calstar/le2-avionics/README.md

# LE2 Avionics 

Hardware for LE2 data acquisition (DAQ) board. 

### [Ground DAQ Spec](https://docs.google.com/document/d/13VDrlMz54n0tT20tYANPPuO85ihRtZlENfx5LBO277A/edit#)  

### [BOM](https://docs.google.com/spreadsheets/d/11PVgNdWwZuFMgkslr21FnstDzzs_OCHczlblnQA5oqc/edit#gid=0)
