calstar/le2-avionics/3d_print_project/le3_periphrialSLDPRT.SLDPRT

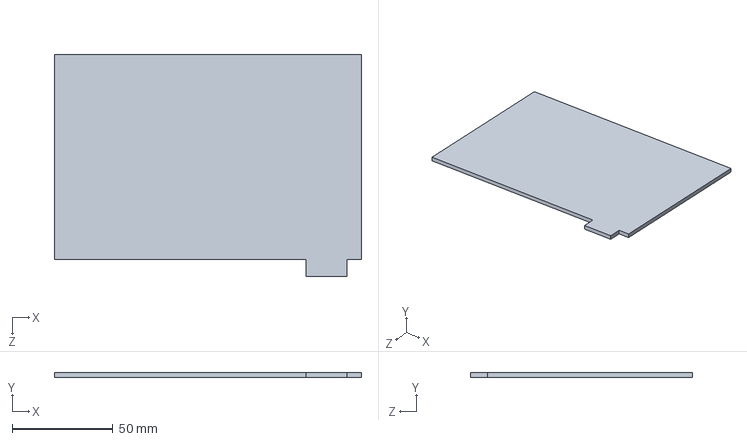
[picture p1: CAD file, 2022-11-15]
3d_print_project/le3_periphrialSLDPRT.SLDPRT
152.4 x 2.54 x 110.0 mm
