calstar/le2-avionics/3d_print_project/le3_core.SLDPRT

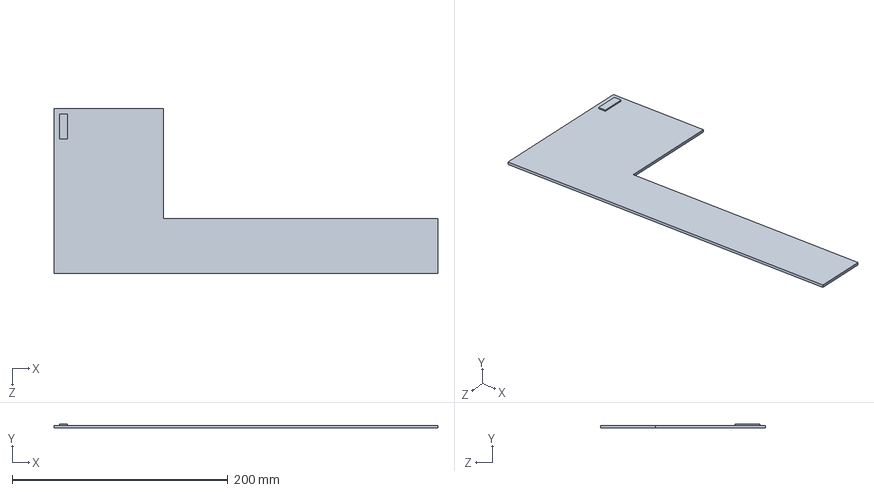
[picture p2: CAD file, 2022-11-15]
3d_print_project/le3_core.SLDPRT
355.6 x 3.81 x 152.4 mm
