calstar/le2-avionics/3d_print_project/final_part.SLDPRT

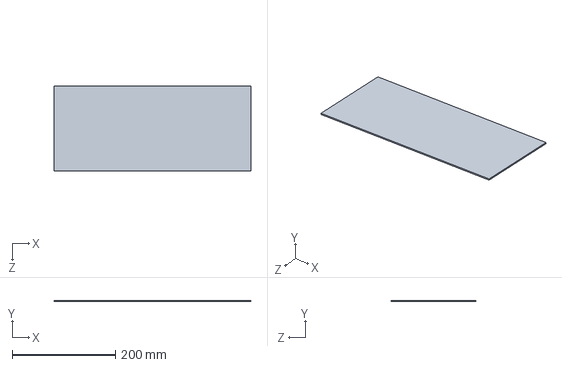
[picture p3: CAD file, 2022-11-15]
3d_print_project/final_part.SLDPRT
381.0 x 2.54 x 165.1 mm
