calstar/le2-avionics/(list of files, cad)

Other CAD files:
3d_print_project/core_board.SLDPRT
