calstar/le2-avionics/core_board/buck_converter.kicad_sch

## KiCad design core_board/buck_converter.kicad_sch (2022-10-28)

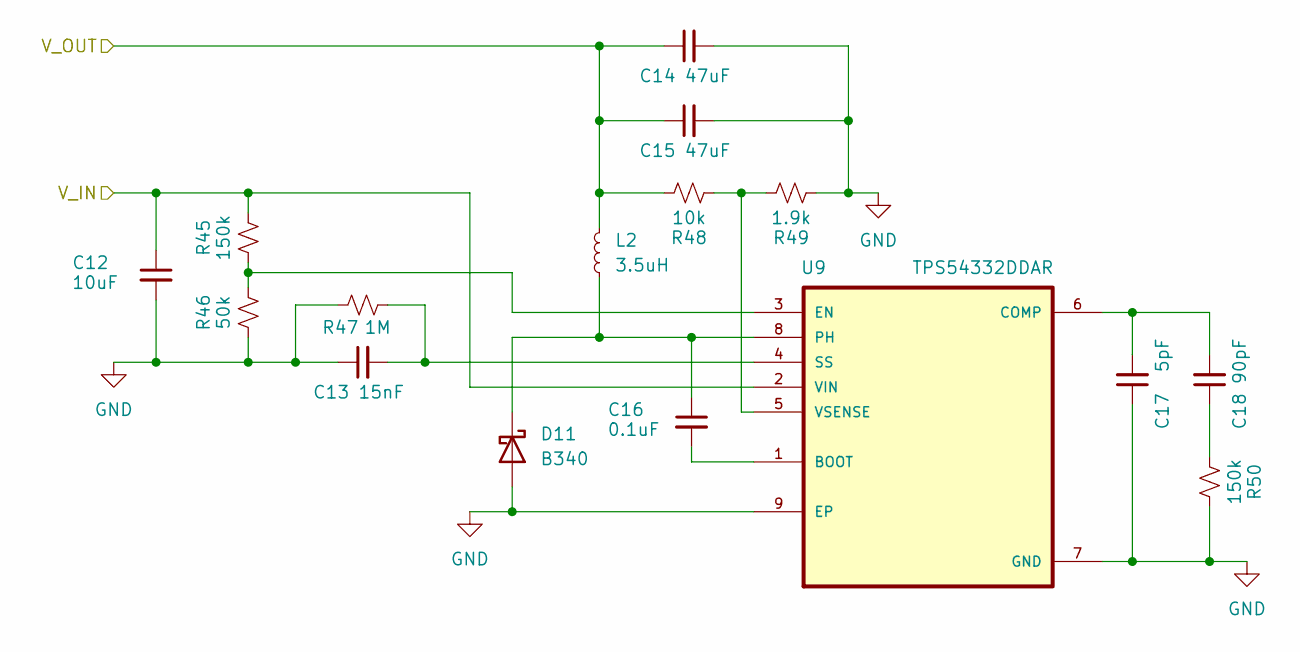
[picture p4: schematic buck_converter.kicad_sch]

Parts:
C12: 10uF; C_0603_1608Metric
C13: 15nF; C_0603_1608Metric
C14, C15: 47uF; C_1206_3216Metric
C16: 0.1uF; C_0603_1608Metric
C17: 5pF; C_0603_1608Metric
C18: 90pF; C_0603_1608Metric
D11: B340; D_SMA
L2: 3.5uH; L_Bourns_SRP5030T
R45, R50: 150k; R_0603_1608Metric
R46: 50k; R_0603_1608Metric
R47: 1M; R_0603_1608Metric
R48: 10k; R_0603_1608Metric
R49: 1.9k; R_0603_1608Metric
U9: TPS54332DDAR; VREG_LM5017MR_NOPB

Connections:
GND: C12.2, C13.1, C14.2, C15.2, C17.1, D11.2 (A), R46.1, R47.1, R49.1, R50.2, U9.7 (GND), U9.9 (EP)
unnamed: C13.2, R47.2, U9.4 (SS)
unnamed: C16.1, D11.1 (K), L2.1, U9.8 (PH)
unnamed: C16.2, U9.1 (BOOT)
unnamed: C17.2, C18.2, U9.6 (COMP)
unnamed: C18.1, R50.1
unnamed: R45.1, R46.2, U9.3 (EN)
unnamed: R48.1, R49.2, U9.5 (VSENSE)
V_IN: C12.1, R45.2, U9.2 (VIN)
V_OUT: C14.1, C15.1, L2.2, R48.2
