calstar/le2-avionics/core_board/core_board.kicad_sch

## KiCad design core_board/core_board.kicad_sch (2022-10-28)

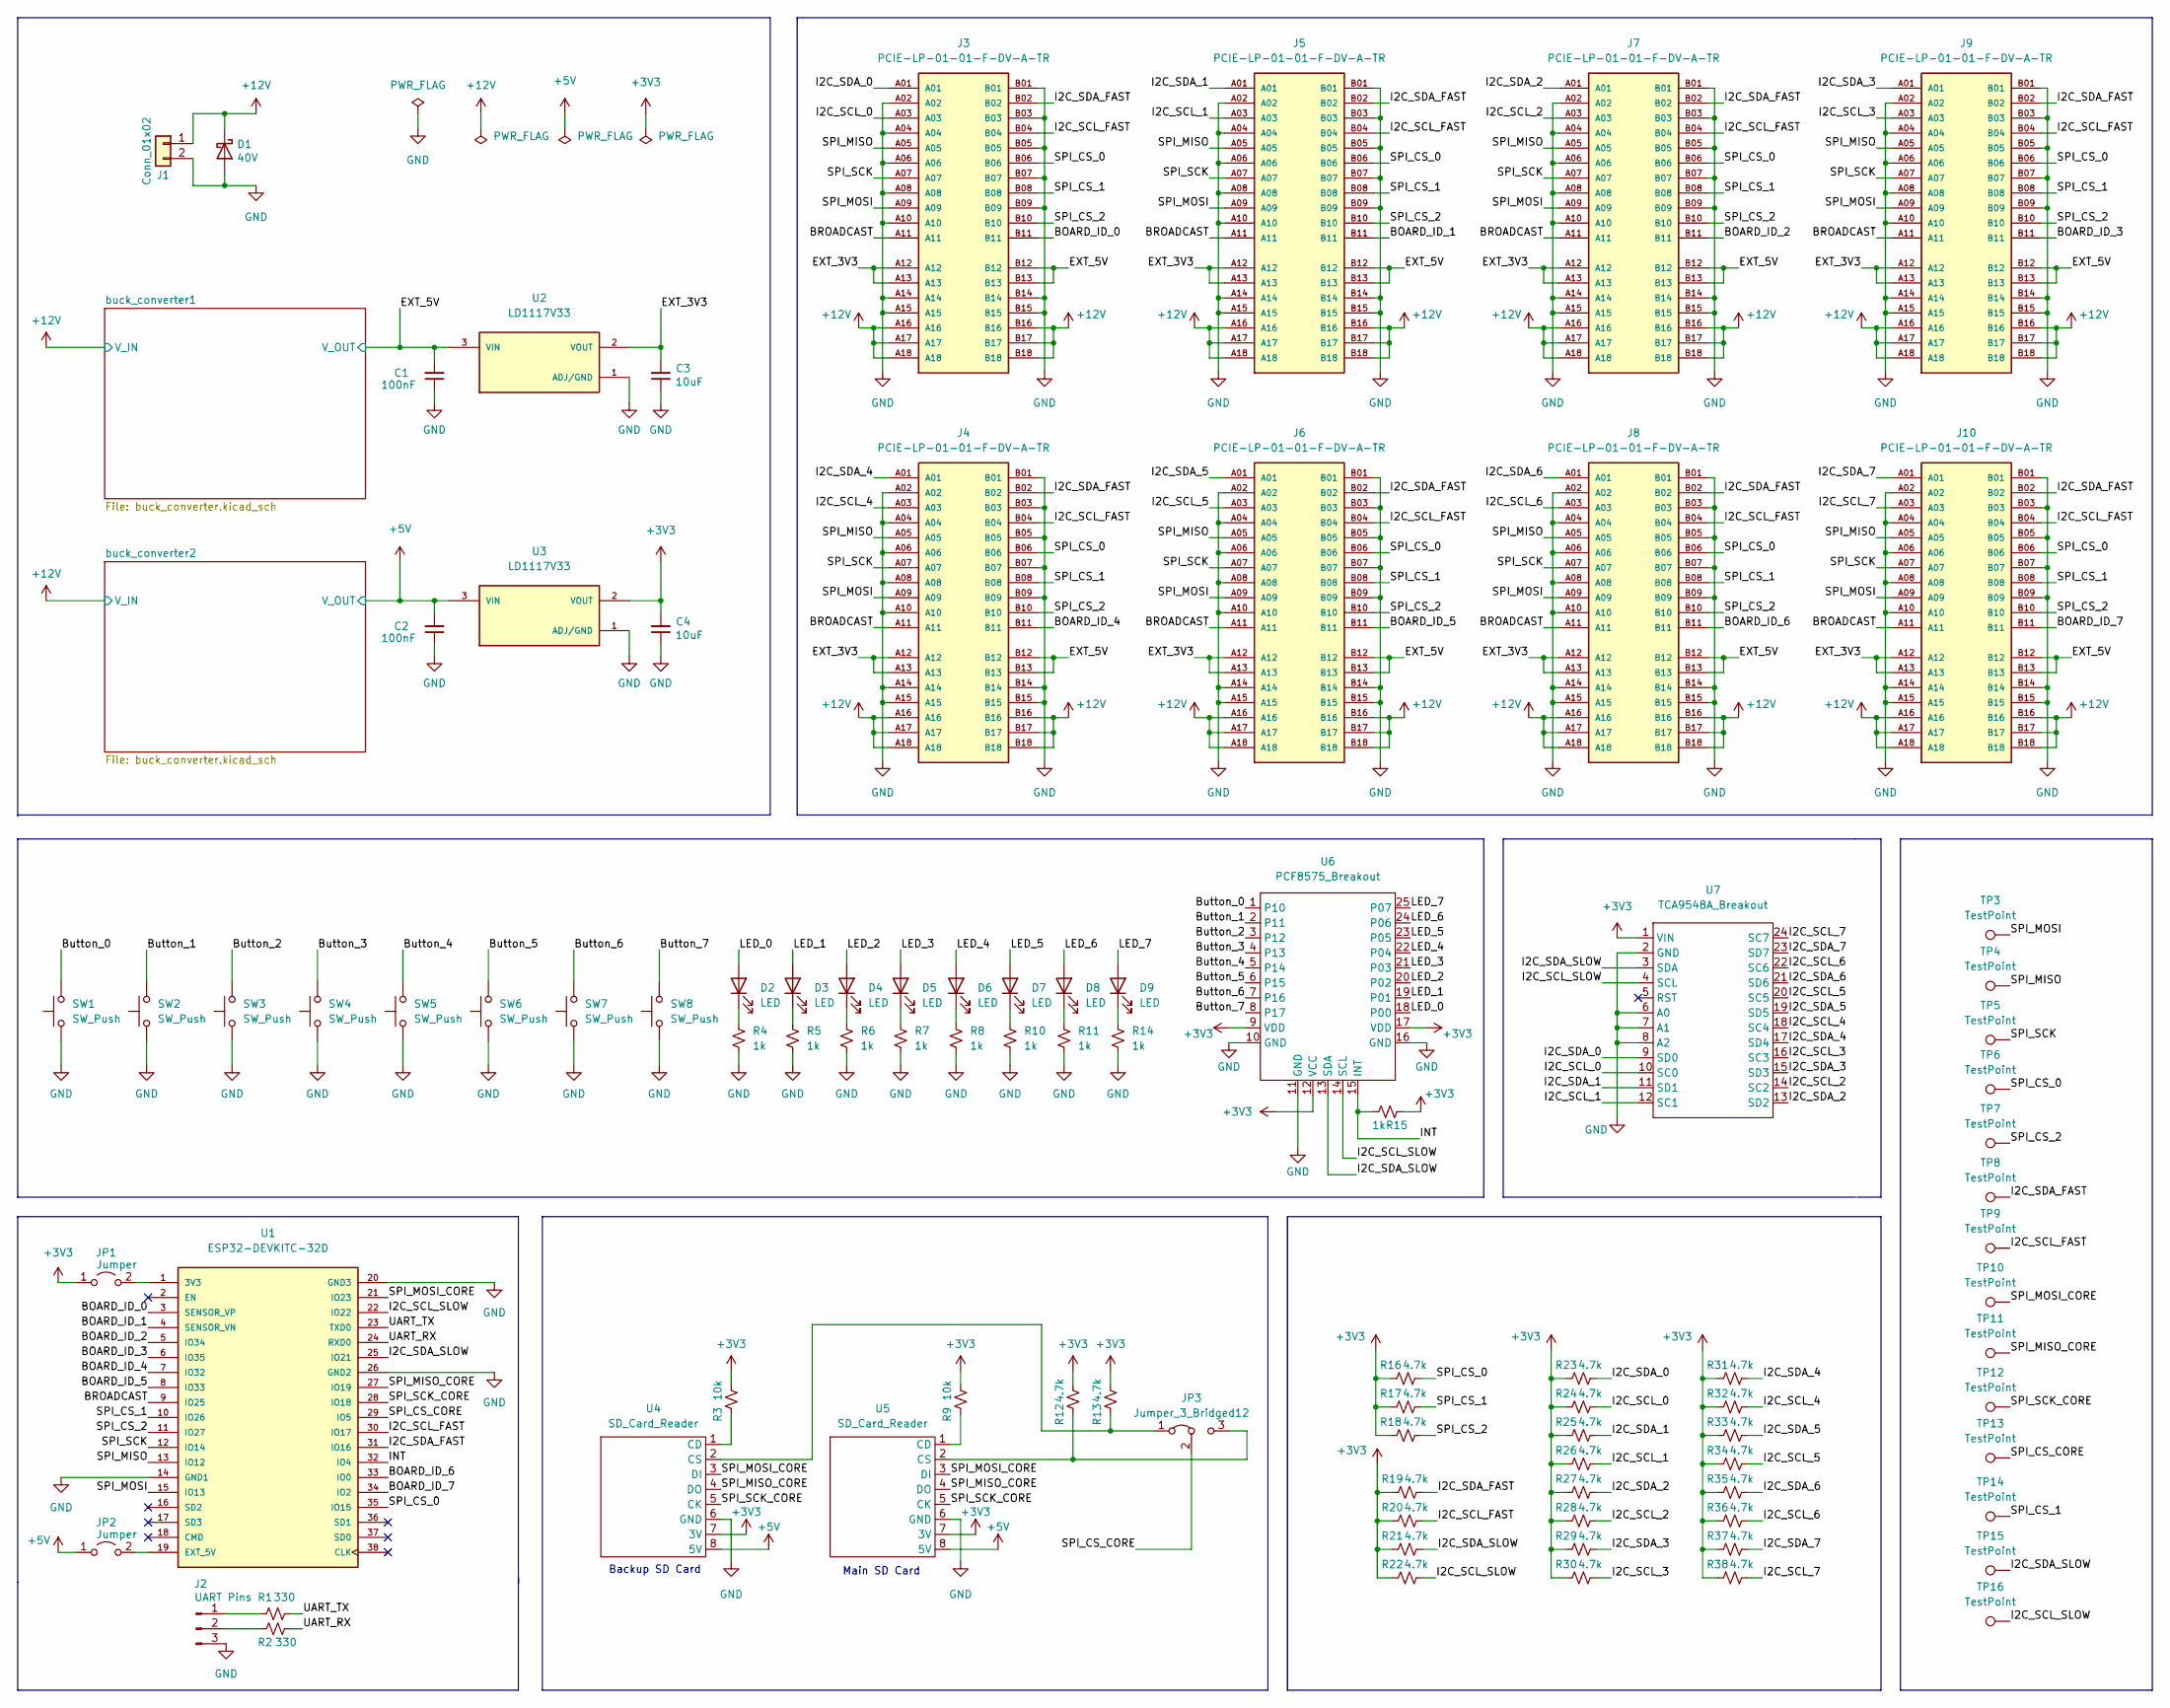
[picture p5: schematic core_board.kicad_sch]

Parts:
C1, C2: 100nF; C_0603_1608Metric
C3, C4: 10uF; C_0603_1608Metric
D1: 40V; D_0603_1608Metric; DIGIKEY 478-7798-1-ND
D2, D3, D4, D5, D6, D7, D8, D9: LED; LED_0603_1608Metric
J1: Conn_01x02; DEANS
J2: UART Pins; PinHeader_1x03_P2.54mm_Vertical
J3, J4, J5, J6, J7, J8, J9, J10: PCIE-LP-01-01-F-DV-A-TR; SAMTEC_PCIE-LP-01-01-F-DV-A-TR; PARTREV B
JP1, JP2: Jumper; PinHeader_1x02_P2.54mm_Vertical
JP3: Jumper_3_Bridged12; PinHeader_1x03_P2.54mm_Vertical
R1, R2: 330; R_0603_1608Metric
R3, R9: 10k; R_0603_1608Metric
R4, R5, R6, R7, R8, R10, R11, R14, R15: 1k; R_0603_1608Metric
R12, R13, R16, R17, R18, R19, R20, R21, R22, R23, R24, R25, R26, R27, R28, R29, R30, R31, R32, R33, R34, R35, R36, R37, R38: 4.7k; R_0603_1608Metric
SW1, SW2, SW3, SW4, SW5, SW6, SW7, SW8: SW_Push; SW_SPST_PTS810
TP3, TP4, TP5, TP6, TP7, TP8, TP9, TP10, TP11, TP12, TP13, TP14, TP15, TP16: TestPoint; TestPoint_Plated_Hole_D2.0mm
U1: ESP32-DEVKITC-32D; MODULE_ESP32-DEVKITC-32D; PARTREV 4
U2, U3: LD1117V33; TO255P1020X450X1968-3; PARTREV 37
U4, U5: SD_Card_Reader; SD_Card_Breakout
U6: PCF8575_Breakout
U7: TCA9548A_Breakout

Connections:
+3V3: C4.2, JP1.1 (A), R3.2, R9.2, R12.2, R13.2, R15.1, R16.1, R17.1, R18.1, R19.1, R20.1, R21.1, R22.1, R23.1, R24.1, R25.1, R26.1, R27.1, R28.1, R29.1, R30.1, R31.1, R32.1, R33.1, R34.1, R35.1, R36.1, R37.1, R38.1, U3.2 (VOUT), U4.7 (3V), U5.7 (3V), U6.9 (VDD), U6.12 (VCC), U6.17 (VDD), U7.1 (VIN)
+5V: C2.2, JP2.1 (A), U3.3 (VIN), U4.8 (5V), U5.8 (5V)
+12V: D1.1 (K), J1.1, J3.A16, J3.A17, J3.A18, J3.B16, J3.B17, J3.B18, J4.A16, J4.A17, J4.A18, J4.B16, J4.B17, J4.B18, J5.A16, J5.A17, J5.A18, J5.B16, J5.B17, J5.B18, J6.A16, J6.A17, J6.A18, J6.B16, J6.B17, J6.B18, J7.A16, J7.A17, J7.A18, J7.B16, J7.B17, J7.B18, J8.A16, J8.A17, J8.A18, J8.B16, J8.B17, J8.B18, J9.A16, J9.A17, J9.A18, J9.B16, J9.B17, J9.B18, J10.A16, J10.A17, J10.A18, J10.B16, J10.B17, J10.B18
BOARD_ID_0: J3.B11, U1.3 (SENSOR_VP)
BOARD_ID_1: J5.B11, U1.4 (SENSOR_VN)
BOARD_ID_2: J7.B11, U1.5 (IO34)
BOARD_ID_3: J9.B11, U1.6 (IO35)
BOARD_ID_4: J4.B11, U1.7 (IO32)
BOARD_ID_5: J6.B11, U1.8 (IO33)
BOARD_ID_6: J8.B11, U1.33 (IO0)
BOARD_ID_7: J10.B11, U1.34 (IO2)
BROADCAST: J3.A11, J4.A11, J5.A11, J6.A11, J7.A11, J8.A11, J9.A11, J10.A11, U1.9 (IO25)
Button_0: SW1.2, U6.1 (P10)
Button_1: SW2.2, U6.2 (P11)
Button_2: SW3.2, U6.3 (P12)
Button_3: SW4.2, U6.4 (P13)
Button_4: SW5.2, U6.5 (P14)
Button_5: SW6.2, U6.6 (P15)
Button_6: SW7.2, U6.7 (P16)
Button_7: SW8.2, U6.8 (P17)
EXT_3V3: C3.2, J3.A12, J3.A13, J4.A12, J4.A13, J5.A12, J5.A13, J6.A12, J6.A13, J7.A12, J7.A13, J8.A12, J8.A13, J9.A12, J9.A13, J10.A12, J10.A13, U2.2 (VOUT)
EXT_5V: C1.2, J3.B12, J3.B13, J4.B12, J4.B13, J5.B12, J5.B13, J6.B12, J6.B13, J7.B12, J7.B13, J8.B12, J8.B13, J9.B12, J9.B13, J10.B12, J10.B13, U2.3 (VIN)
GND: C1.1, C2.1, C3.1, C4.1, D1.2 (A), J1.2, J2.3, J3.A02, J3.A04, J3.A06, J3.A08, J3.A10, J3.A14, J3.A15, J3.B01, J3.B03, J3.B05, J3.B07, J3.B09, J3.B14, J3.B15, J4.A02, J4.A04, J4.A06, J4.A08, J4.A10, J4.A14, J4.A15, J4.B01, J4.B03, J4.B05, J4.B07, J4.B09, J4.B14, J4.B15, J5.A02, J5.A04, J5.A06, J5.A08, J5.A10, J5.A14, J5.A15, J5.B01, J5.B03, J5.B05, J5.B07, J5.B09, J5.B14, J5.B15, J6.A02, J6.A04, J6.A06, J6.A08, J6.A10, J6.A14, J6.A15, J6.B01, J6.B03, J6.B05, J6.B07, J6.B09, J6.B14, J6.B15, J7.A02, J7.A04, J7.A06, J7.A08, J7.A10, J7.A14, J7.A15, J7.B01, J7.B03, J7.B05, J7.B07, J7.B09, J7.B14, J7.B15, J8.A02, J8.A04, J8.A06, J8.A08, J8.A10, J8.A14, J8.A15, J8.B01, J8.B03, J8.B05, J8.B07, J8.B09, J8.B14, J8.B15, J9.A02, J9.A04, J9.A06, J9.A08, J9.A10, J9.A14, J9.A15, J9.B01, J9.B03, J9.B05, J9.B07, J9.B09, J9.B14, J9.B15, J10.A02, J10.A04, J10.A06, J10.A08, J10.A10, J10.A14, J10.A15, J10.B01, J10.B03, J10.B05, J10.B07, J10.B09, J10.B14, J10.B15, R4.2, R5.2, R6.2, R7.2, R8.2, R10.2, R11.2, R14.2, SW1.1, SW2.1, SW3.1, SW4.1, SW5.1, SW6.1, SW7.1, SW8.1, U1.14 (GND1), U1.20 (GND3), U1.26 (GND2), U2.1 (ADJ/GND), U3.1 (ADJ/GND), U4.6 (GND), U5.6 (GND), U6.10 (GND), U6.11 (GND), U6.16 (GND), U7.2 (GND), U7.6 (A0), U7.7 (A1), U7.8 (A2)
I2C_SCL_0: J3.A03, R24.2, U7.10 (SC0)
I2C_SCL_1: J5.A03, R26.2, U7.12 (SC1)
I2C_SCL_2: J7.A03, R28.2, U7.14 (SC2)
I2C_SCL_3: J9.A03, R30.2, U7.16 (SC3)
I2C_SCL_4: J4.A03, R32.2, U7.18 (SC4)
I2C_SCL_5: J6.A03, R34.2, U7.20 (SC5)
I2C_SCL_6: J8.A03, R36.2, U7.22 (SC6)
I2C_SCL_7: J10.A03, R38.2, U7.24 (SC7)
I2C_SCL_FAST: J3.B04, J4.B04, J5.B04, J6.B04, J7.B04, J8.B04, J9.B04, J10.B04, R20.2, TP9.1, U1.30 (IO17)
I2C_SCL_SLOW: R22.2, TP16.1, U1.22 (IO22), U6.14 (SCL), U7.4 (SCL)
I2C_SDA_0: J3.A01, R23.2, U7.9 (SD0)
I2C_SDA_1: J5.A01, R25.2, U7.11 (SD1)
I2C_SDA_2: J7.A01, R27.2, U7.13 (SD2)
I2C_SDA_3: J9.A01, R29.2, U7.15 (SD3)
I2C_SDA_4: J4.A01, R31.2, U7.17 (SD4)
I2C_SDA_5: J6.A01, R33.2, U7.19 (SD5)
I2C_SDA_6: J8.A01, R35.2, U7.21 (SD6)
I2C_SDA_7: J10.A01, R37.2, U7.23 (SD7)
I2C_SDA_FAST: J3.B02, J4.B02, J5.B02, J6.B02, J7.B02, J8.B02, J9.B02, J10.B02, R19.2, TP8.1, U1.31 (IO16)
I2C_SDA_SLOW: R21.2, TP15.1, U1.25 (IO21), U6.13 (SDA), U7.3 (SDA)
INT: R15.2, U1.32 (IO4), U6.15 (INT)
LED_0: D2.2 (A), U6.18 (P00)
LED_1: D3.2 (A), U6.19 (P01)
LED_2: D4.2 (A), U6.20 (P02)
LED_3: D5.2 (A), U6.21 (P03)
LED_4: D6.2 (A), U6.22 (P04)
LED_5: D7.2 (A), U6.23 (P05)
LED_6: D8.2 (A), U6.24 (P06)
LED_7: D9.2 (A), U6.25 (P07)
unnamed: D2.1 (K), R4.1
unnamed: D3.1 (K), R5.1
unnamed: D4.1 (K), R6.1
unnamed: D5.1 (K), R7.1
unnamed: D6.1 (K), R8.1
unnamed: D7.1 (K), R10.1
unnamed: D8.1 (K), R11.1
unnamed: D9.1 (K), R14.1
unnamed: J2.1, R1.1
unnamed: J2.2, R2.1
unnamed: JP1.2 (B), U1.1 (3V3)
unnamed: JP2.2 (B), U1.19 (EXT_5V)
unnamed: JP3.1 (A), R13.1, U4.2 (CS)
unnamed: JP3.3 (B), R12.1, U5.2 (CS)
unnamed: R3.1, U4.1 (CD)
unnamed: R9.1, U5.1 (CD)
SPI_CS_0: J3.B06, J4.B06, J5.B06, J6.B06, J7.B06, J8.B06, J9.B06, J10.B06, R16.2, TP6.1, U1.35 (IO15)
SPI_CS_1: J3.B08, J4.B08, J5.B08, J6.B08, J7.B08, J8.B08, J9.B08, J10.B08, R17.2, TP14.1, U1.10 (IO26)
SPI_CS_2: J3.B10, J4.B10, J5.B10, J6.B10, J7.B10, J8.B10, J9.B10, J10.B10, R18.2, TP7.1, U1.11 (IO27)
SPI_CS_CORE: JP3.2 (C), TP13.1, U1.29 (IO5)
SPI_MISO: J3.A05, J4.A05, J5.A05, J6.A05, J7.A05, J8.A05, J9.A05, J10.A05, TP4.1, U1.13 (IO12)
SPI_MISO_CORE: TP11.1, U1.27 (IO19), U4.4 (DO), U5.4 (DO)
SPI_MOSI: J3.A09, J4.A09, J5.A09, J6.A09, J7.A09, J8.A09, J9.A09, J10.A09, TP3.1, U1.15 (IO13)
SPI_MOSI_CORE: TP10.1, U1.21 (IO23), U4.3 (DI), U5.3 (DI)
SPI_SCK: J3.A07, J4.A07, J5.A07, J6.A07, J7.A07, J8.A07, J9.A07, J10.A07, TP5.1, U1.12 (IO14)
SPI_SCK_CORE: TP12.1, U1.28 (IO18), U4.5 (CK), U5.5 (CK)
UART_RX: R2.2, U1.24 (RXD0)
UART_TX: R1.2, U1.23 (TXD0)

Notes on the sheet:
Main SD Card
Backup SD Card
