calstar/le2-avionics/(commit log)

2022-09-13 igniter schematic work in progress
    [igniter_board.kicad_pcb, igniter_board.kicad_sch]
2022-09-18 Started on Core Board schematic
    [core_board.kicad_pcb, core_board.kicad_sch]
2022-09-23 small updates
    [core_board.kicad_sch]
2022-09-26 finished schematic
    [core_board.kicad_sch]
2022-09-26 updated to 15-pin dsub
    [core_board.kicad_sch]
2022-09-30 Revised schematic based on Trevor's plan
    [core_board.kicad_sch]
2022-10-01 incorporated changed from design review meeting
    [core_board.kicad_sch]
2022-10-02 added LDO
    [buck_converter.kicad_sch, core_board.kicad_sch]
2022-10-02 small changes
    [core_board.kicad_sch]
2022-10-02 added PCIE connectors
    [core_board.kicad_sch]
2022-10-08 d-sub pin assignment rtds
    [pt_rtd_board.kicad_sch, rtd_board.kicad_sch]
2022-10-09 cleaning up
    [rtd_board.kicad_sch]
2022-10-09 removing accidentally added folder
    [pt_rtd_board.kicad_sch]
2022-10-09 Removing accidentally added files
    [rtd_board.kicad_sch]
2022-10-13 last commit before starting layout
    [core_board.kicad_sch]
2022-10-13 created netlist
    [buck_converter.kicad_sch, core_board.kicad_sch]
2022-10-14 did layout, and power routing
    [core_board.kicad_pcb, core_board.kicad_sch]
2022-10-15 more routing progress
    [core_board.kicad_pcb, core_board.kicad_sch]
2022-10-15 more routing
    [core_board.kicad_pcb]
2022-10-17 minor edits
    [core_board-B_Cu.gbr, core_board-B_Mask.gbr, core_board-B_Paste.gbr, core_board-B_Silkscreen.gbr, core_board-Edge_Cuts.gbr, core_board-F_Cu.gbr, core_board-F_Mask.gbr, core_board-F_Paste.gbr]
2022-10-17 minor changes
    [core_board-B_Cu.gbr, core_board-B_Mask.gbr, core_board-B_Paste.gbr, core_board-B_Silkscreen.gbr, core_board-Edge_Cuts.gbr, core_board-F_Cu.gbr, core_board-F_Mask.gbr, core_board-F_Paste.gbr]
2022-10-21 small edits to power supply
    [buck_converter.kicad_sch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]
2022-10-23 added screw terminals
    [rtd_board.kicad_sch]
2022-10-27 mounting holes
2022-11-01 more mounting holes the more the merrier
    [core_board-B_Cu.gbr, core_board-B_Mask.gbr, core_board-B_Paste.gbr, core_board-B_Silkscreen.gbr, core_board-Edge_Cuts.gbr, core_board-F_Cu.gbr, core_board-F_Mask.gbr, core_board-F_Paste.gbr]
2022-11-01 changed shape of core board
    [core_board-B_Cu.gbr, core_board-B_Mask.gbr, core_board-B_Paste.gbr, core_board-B_Silkscreen.gbr, core_board-Edge_Cuts.gbr, core_board-F_Cu.gbr, core_board-F_Mask.gbr, core_board-F_Paste.gbr]
2022-11-04 moved UART pins
    [core_board-B_Cu.gbr, core_board-B_Mask.gbr, core_board-B_Paste.gbr, core_board-B_Silkscreen.gbr, core_board-Edge_Cuts.gbr, core_board-F_Cu.gbr, core_board-F_Mask.gbr, core_board-F_Paste.gbr]
2022-11-04 updated gerbers for core board
    [core_board-B_Cu.gbr, core_board-B_Mask.gbr, core_board-B_Paste.gbr, core_board-B_Silkscreen.gbr, core_board-Edge_Cuts.gbr, core_board-F_Cu.gbr, core_board-F_Mask.gbr, core_board-F_Paste.gbr]
2022-11-08 added sldprt files for board specs first draft
    [core_board.SLDPRT, final_part.SLDPRT, le3_core.SLDPRT, le3_periphrialSLDPRT.SLDPRT]
2022-11-23 IO Expander code fixed, added more code
    [CoreBoard.cpp, GroundTest.ino]
2022-11-23 wrote code to test igniter board
2022-11-24 added code for RTD board
2022-11-24 wrote code for PT Board
2022-11-26 updated thermocouple board code
2022-11-27 added buttons-and-leds testing file
2022-11-27 rtd circuit sim
2022-12-16 igniter board code works
2022-12-17 more work on PT board code
